Esteves4/Smartbee/README.md

# Sm@rtbee
The main objective of this project is to describe the behavior of bees in healthy hives and ready for pollination. Through real-time and minimally invasive monitoring, data from hives and colonies will be collected through heterogeneous sensors, connected to sensing devices with embedded radios. The data will be stored in a computational cloud and accessed remotely via the Web.

## Getting Started

If you want to know how to assemble the sensor nodes, go [here](Nodes/sensor).

If you want to know how to assemble the gateway, go [here](Nodes/gateway).

## License

This project is licensed under the MIT License - see the [LICENSE.md](LICENSE) file for details
