Esteves4/Smartbee/Data/Avaliação bateria - Gsm + ArduinoMega/tensãox tempo.png

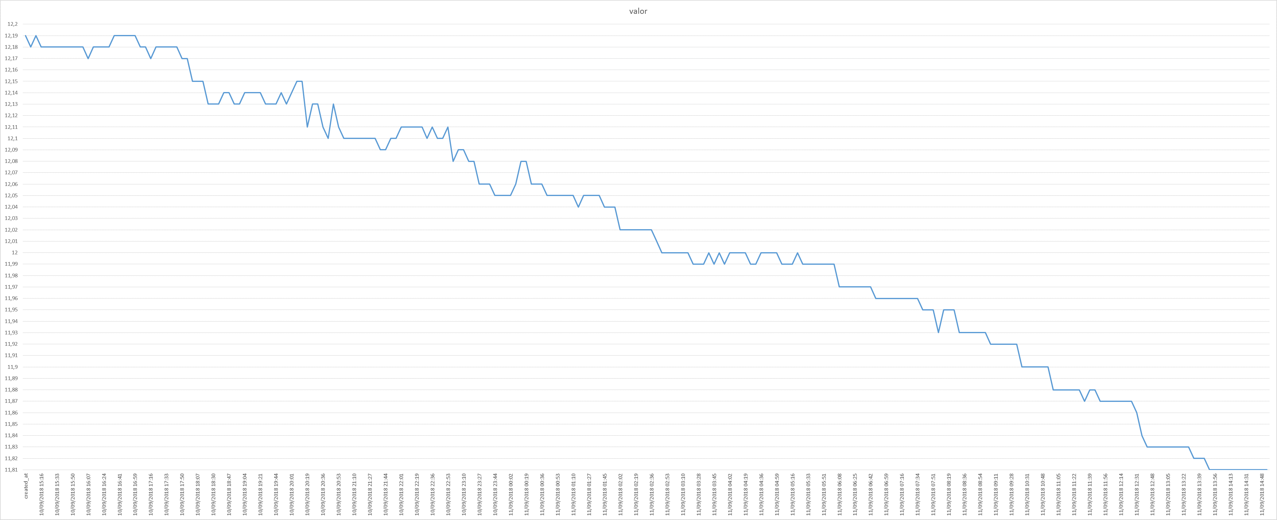
Data/Avaliação bateria - Gsm + ArduinoMega/tensãox tempo.png
