Esteves4/Smartbee/Scale/scaleFactor/scaleFactor.ino

/*
 * circuits4you.com
 * 2016 November 25
 * Load Cell HX711 Module Interface with Arduino to measure weight in Kgs
 Arduino 
 pin 
 2 -> HX711 CLK
 3 -> DOUT
 5V -> VCC
 GND -> GND
 
 Most any pin on the Arduino Uno will be compatible with DOUT/CLK.
 The HX711 board can be powered from 2.7V to 5V so the Arduino 5V power should be fine.
*/
 
#include <HX711.h>  //You must have this library in your arduino library folder
 

//INITIAL CONFIGURATION OF HX711
#define DOUT  3
#define CLK  4

HX711 scale(DOUT, CLK);
 
//Change this calibration factor as per your load cell once it is found you many need to vary it in thousands
float calibration_factor = 42990; //-106600 worked for my 40Kg max scale setup 
 
//=============================================================================================
//                         SETUP
//=============================================================================================
void setup() {
  Serial.begin(57600);
  Serial.println("HX711 Calibration");
  Serial.println("Remove all weight from scale");
  Serial.println("After readings begin, place known weight on scale");
  Serial.println("Press a,s,d,f to increase calibration factor by 10,100,1000,10000 respectively");
  Serial.println("Press z,x,c,v to decrease calibration factor by 10,100,1000,10000 respectively");
  Serial.println("Press t for tare");
  scale.set_scale();
  
  long zero_factor = scale.read_average(10); //Get a baseline reading
  Serial.print("Zero factor: "); //This can be used to remove the need to tare the scale. Useful in permanent scale projects.
  Serial.println(zero_factor);
  scale.set_offset(zero_factor);
}
 
//=============================================================================================
//                         LOOP
//=============================================================================================
void loop() {
 
  scale.set_scale(calibration_factor); //Adjust to this calibration factor
 
  Serial.print("Reading: ");
  Serial.print(scale.get_units(10), 3);
  Serial.print(" kg"); //Change this to kg and re-adjust the calibration factor if you follow SI units like a sane person
  Serial.print(" calibration_factor: ");
  Serial.print(calibration_factor);
  Serial.println();
 
  if(Serial.available())
  {
    char temp = Serial.read();
    if(temp == '+' || temp == 'a')
      calibration_factor += 10;
    else if(temp == '-' || temp == 'z')
      calibration_factor -= 10;
    else if(temp == 's')
      calibration_factor += 100;  
    else if(temp == 'x')
      calibration_factor -= 100;  
    else if(temp == 'd')
      calibration_factor += 1000;  
    else if(temp == 'c')
      calibration_factor -= 1000;
    else if(temp == 'f')
      calibration_factor += 10000;  
    else if(temp == 'v')
      calibration_factor -= 10000;  
    else if(temp == 't')
      scale.tare();  //Reset the scale to zero
  }
}
//=============================================================================================
