Esteves4/Smartbee/(commit log)

2018-04-30 Test files
    [diff.txt]
2018-05-14 Adding Scale project
    [diff.txt]
2018-05-14 Update folder name
    [diff.txt]
2018-05-14 Updating README.md
    [diff.txt]
2018-05-14 Adding Arduino files
2018-07-24 Low Power Sketch files
2018-08-20 Failed attempt to use SD Card on nodeCentral
    [nodeCentral.ino]
2018-08-31 Configurations updated for ArduinoMega as central node
2018-09-10 Get Battery Voltage
2018-09-13 Interrupts now is used just to wake arduino up. To receive the payload, the antenna's buffer is polled for 10s
    [temp.csv, temp.xlsx]
2018-10-16 Arduino saves payloads properly when GSM fails
2018-10-16 Arduino sends payload from ArrayPayloads if SDCard fails
2018-12-14 Sensor -> CentralNode working - audio not working yet
2018-12-17 Tryning to find why MQTT doesn't work
    [Tests.py]
2018-12-17 Publishing message needs fixing
    [Tests.py]
2019-01-24 Adjusting sensor node
2019-02-01 Using thread to send data to server (GSM transmission)
2019-02-06 sensor audio upload
2019-02-07 Mega as sensor node
2019-02-14 Getting battery voltage by an average of 10 samples
2019-03-12 fixing extern temperature collect
2019-03-12 Fixing external temperature collect
2019-04-25 Adding scale power up and down functions
2019-05-07 Organizing directories
    [diff.txt]
